MakerSpaceNewcastle/access-control-gen2/hw/RfidPillar.stl

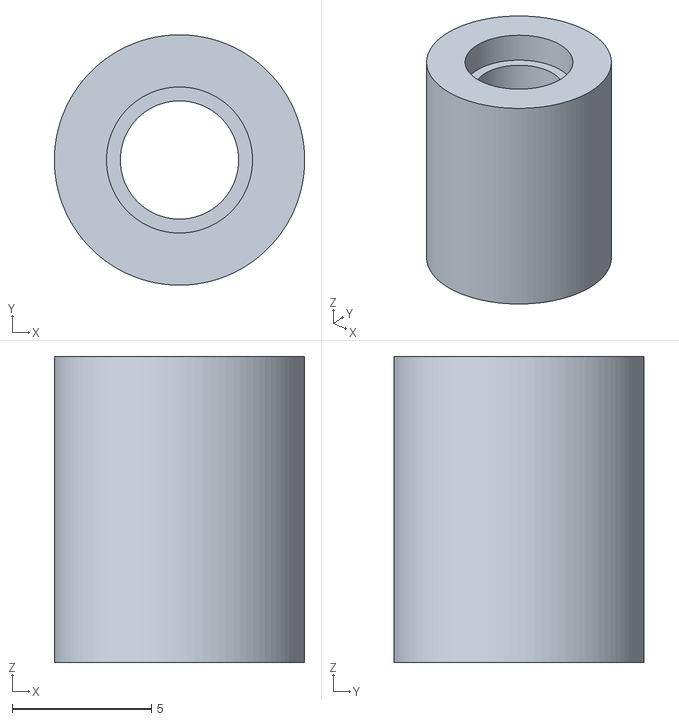
[picture p2: CAD file, 2026-01-13]
hw/RfidPillar.stl
9.00 x 9.00 x 11.0
