MakerSpaceNewcastle/access-control-gen2/hw/lv_enclosure/box.scad

use <enclosure.scad>;

Box();
