MakerSpaceNewcastle/access-control-gen2/hw/lv_enclosure/lid.scad

use <enclosure.scad>;

projection() {
  Lid();
}
