MakerSpaceNewcastle/access-control-gen2/(list of files, cad)

Other CAD files:
hw/lv_enclosure/controller_pcb.scad
