MakerSpaceNewcastle/access-control-gen2/pcb/controller/controller.kicad_pcb

## KiCad design pcb/controller/controller.kicad_pcb (2026-06-05)

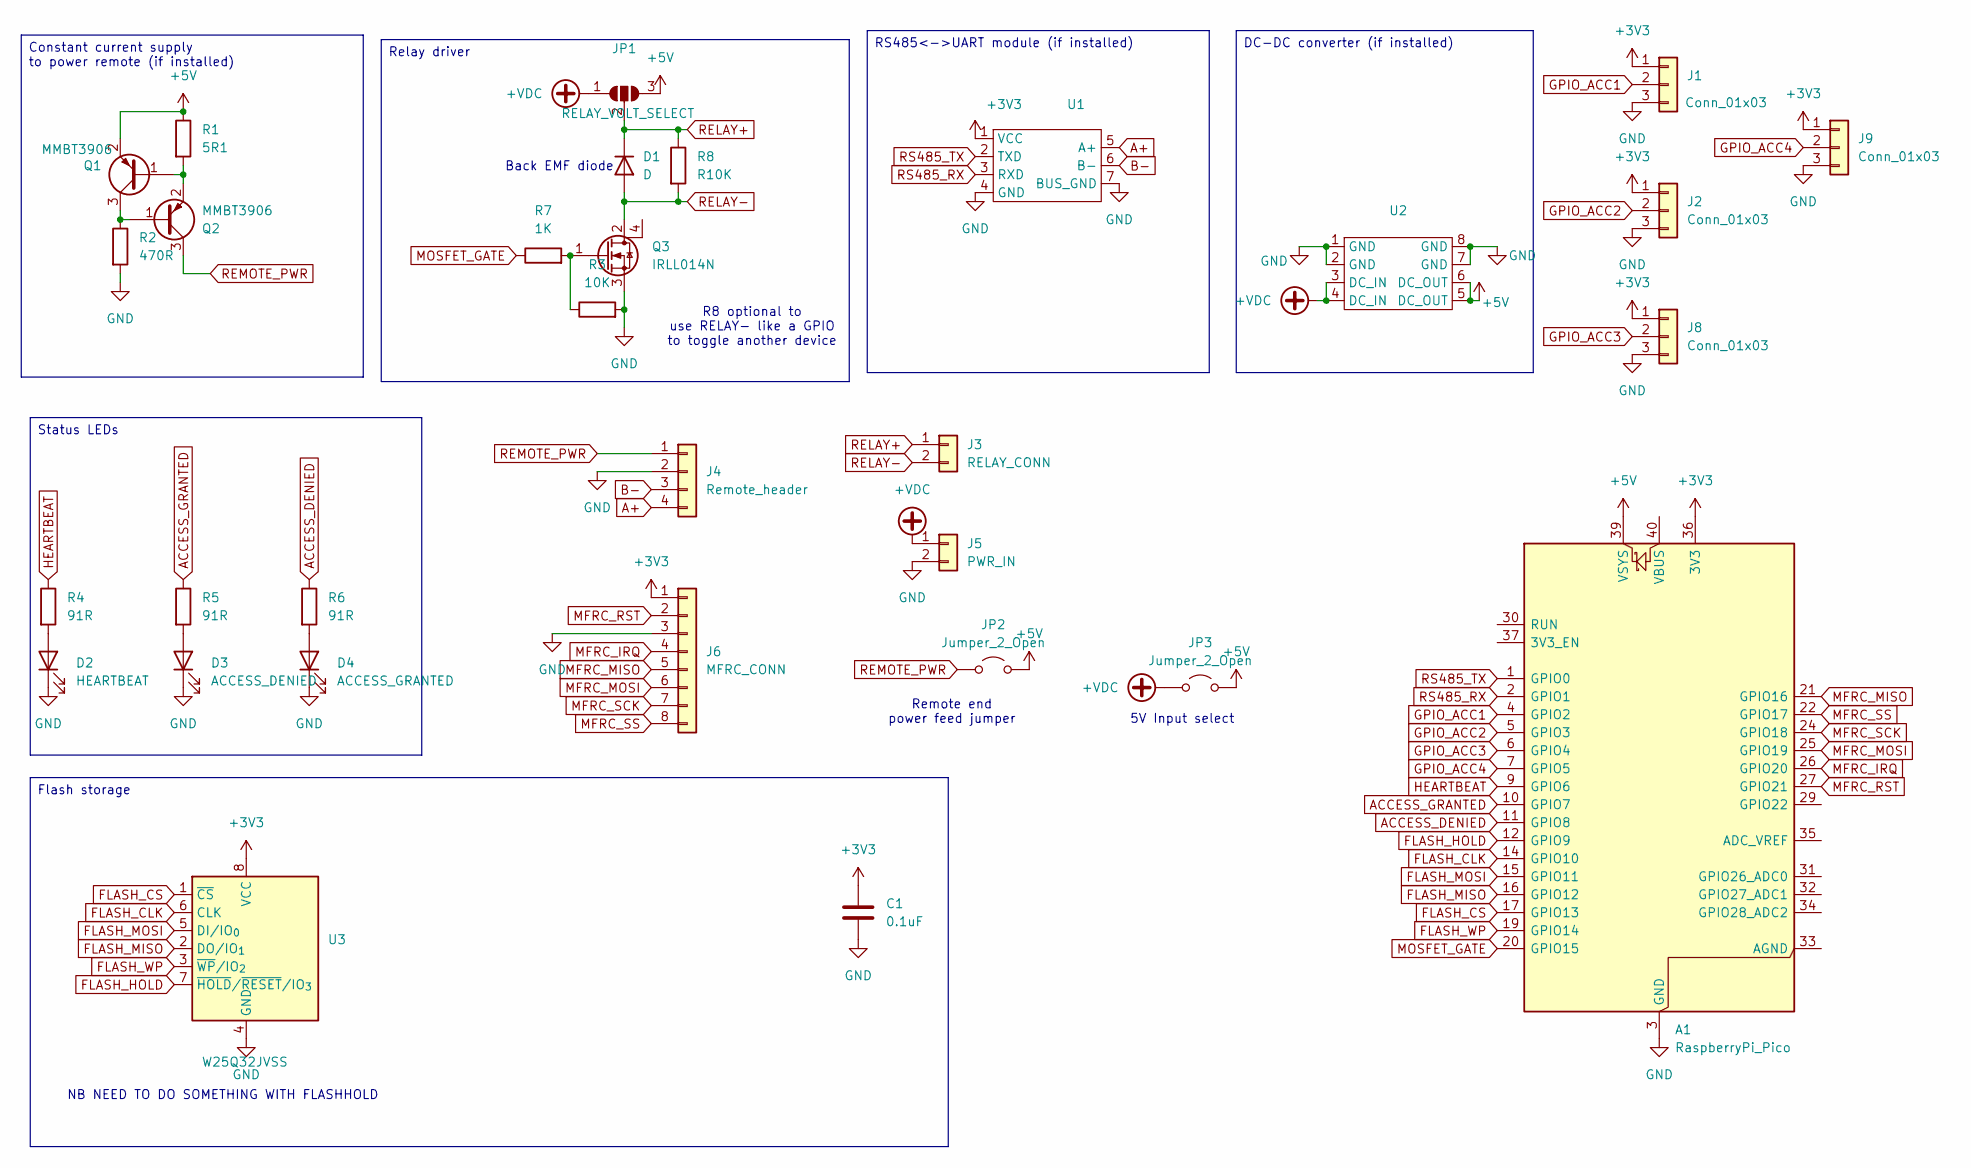
[picture p3: schematic controller.kicad_sch]

Parts:
A1: RaspberryPi_Pico; RaspberryPi_Pico_Common_Unspecified
C1: 0.1uF; C_1206_3216Metric_Pad1.33x1.80mm_HandSolder
D1: D; D_SMA-SMB_Universal_Handsoldering
D2: HEARTBEAT; LED_1206_3216Metric_Pad1.42x1.75mm_HandSolder
D3: ACCESS_DENIED; LED_1206_3216Metric_Pad1.42x1.75mm_HandSolder
D4: ACCESS_GRANTED; LED_1206_3216Metric_Pad1.42x1.75mm_HandSolder
J1, J2, J8, J9: Conn_01x03; JST_XH_B3B-XH-A_1x03_P2.50mm_Vertical
J3: RELAY_CONN; TerminalBlock_MetzConnect_Type059_RT06302HBWC_1x02_P3.50mm_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
J4: Remote_header; TerminalBlock_MetzConnect_Type059_RT06304HBWC_1x04_P3.50mm_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
J5: PWR_IN; TerminalBlock_MetzConnect_Type059_RT06302HBWC_1x02_P3.50mm_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
J6: MFRC_CONN; PinHeader_1x08_P2.54mm_Vertical
JP1: RELAY_VOLT_SELECT; SolderJumper-3_P1.3mm_Open_Pad1.0x1.5mm
JP2, JP3: Jumper_2_Open; SolderJumper-2_P1.3mm_Open_Pad1.0x1.5mm
Q1, Q2: MMBT3906; SOT-23
Q3: IRLL014N; SOT-223-3_TabPin2
R1: 5R1; R_1210_3225Metric_Pad1.30x2.65mm_HandSolder
R2: 470R; R_1210_3225Metric_Pad1.30x2.65mm_HandSolder
R3: 10K; R_1210_3225Metric_Pad1.30x2.65mm_HandSolder
R4, R5, R6: 91R; R_1210_3225Metric_Pad1.30x2.65mm_HandSolder
R7: 1K; R_1210_3225Metric_Pad1.30x2.65mm_HandSolder
R8: R10K; R_1210_3225Metric_Pad1.30x2.65mm_HandSolder
U1: RS485_to_ttl
U2: hw-1338
U3: W25Q32JVSS; SOIC-8_5.3x5.3mm_P1.27mm

Connections:
+3V3: A1.36 (3V3), C1.1, J1.1, J2.1, J6.1, J8.1, J9.1, U1.1 (VCC), U3.8 (VCC)
+5V: A1.39 (VSYS), JP1.3 (B), JP2.2 (B), JP3.2 (B), Q1.2 (E), R1.1, U2.5 (DC_OUT), U2.6 (DC_OUT)
+VDC: J5.1, JP1.1 (A), JP3.1 (A), U2.3 (DC_IN), U2.4 (DC_IN)
A+: J4.4, U1.5 (A+)
ACCESS_DENIED: A1.11 (GPIO8), R6.1
ACCESS_GRANTED: A1.10 (GPIO7), R5.1
B-: J4.3, U1.6 (B-)
FLASH_CLK: A1.14 (GPIO10), U3.6 (CLK)
FLASH_CS: A1.17 (GPIO13), U3.1 (~CS)
FLASH_HOLD: A1.12 (GPIO9), U3.7 (~HOLD/~RESET/IO_{3})
FLASH_MISO: A1.16 (GPIO12), U3.2 (DO/IO_{1})
FLASH_MOSI: A1.15 (GPIO11), U3.5 (DI/IO_{0})
FLASH_WP: A1.19 (GPIO14), U3.3 (~WP/IO_{2})
GND: A1.3 (GND), A1.8 (GND), A1.13 (GND), A1.18 (GND), A1.23 (GND), A1.28 (GND), A1.38 (GND), C1.2, D2.1 (K), D3.1 (K), D4.1 (K), J1.3, J2.3, J4.2, J5.2, J6.3, J8.3, J9.3, Q3.3 (S), R2.2, R3.2, U1.4 (GND), U1.7 (BUS_GND), U2.1 (GND), U2.2 (GND), U2.7 (GND), U2.8 (GND), U3.4 (GND)
GPIO_ACC1: A1.4 (GPIO2), J1.2
GPIO_ACC2: A1.5 (GPIO3), J2.2
GPIO_ACC3: A1.6 (GPIO4), J8.2
GPIO_ACC4: A1.7 (GPIO5), J9.2
HEARTBEAT: A1.9 (GPIO6), R4.1
MFRC_IRQ: A1.26 (GPIO20), J6.4
MFRC_MISO: A1.21 (GPIO16), J6.5
MFRC_MOSI: A1.25 (GPIO19), J6.6
MFRC_RST: A1.27 (GPIO21), J6.2
MFRC_SCK: A1.24 (GPIO18), J6.7
MFRC_SS: A1.22 (GPIO17), J6.8
MOSFET_GATE: A1.20 (GPIO15), R7.1
unnamed: D2.2 (A), R4.2
unnamed: D3.2 (A), R5.2
unnamed: D4.2 (A), R6.2
unnamed: Q1.1 (B), Q2.2 (E), R1.2
unnamed: Q1.3 (C), Q2.1 (B), R2.1
unnamed: Q3.1 (G), R3.1, R7.2
RELAY+: D1.1 (K), J3.1, JP1.2 (C), R8.1
RELAY-: D1.2 (A), J3.2, Q3.2 (D), R8.2
REMOTE_PWR: J4.1, JP2.1 (A), Q2.3 (C)
RS485_RX: A1.2 (GPIO1), U1.3 (RXD)
RS485_TX: A1.1 (GPIO0), U1.2 (TXD)

Notes on the sheet:
NB NEED TO DO SOMETHING WITH FLASHHOLD
Back EMF diode
R8 optional to use RELAY- like a GPIO to toggle another device
Remote end power feed jumper
5V Input select
Status LEDs
DC-DC converter (if installed)
Relay driver
RS485<->UART module (if installed)
Flash storage
Constant current supply to power remote (if installed)

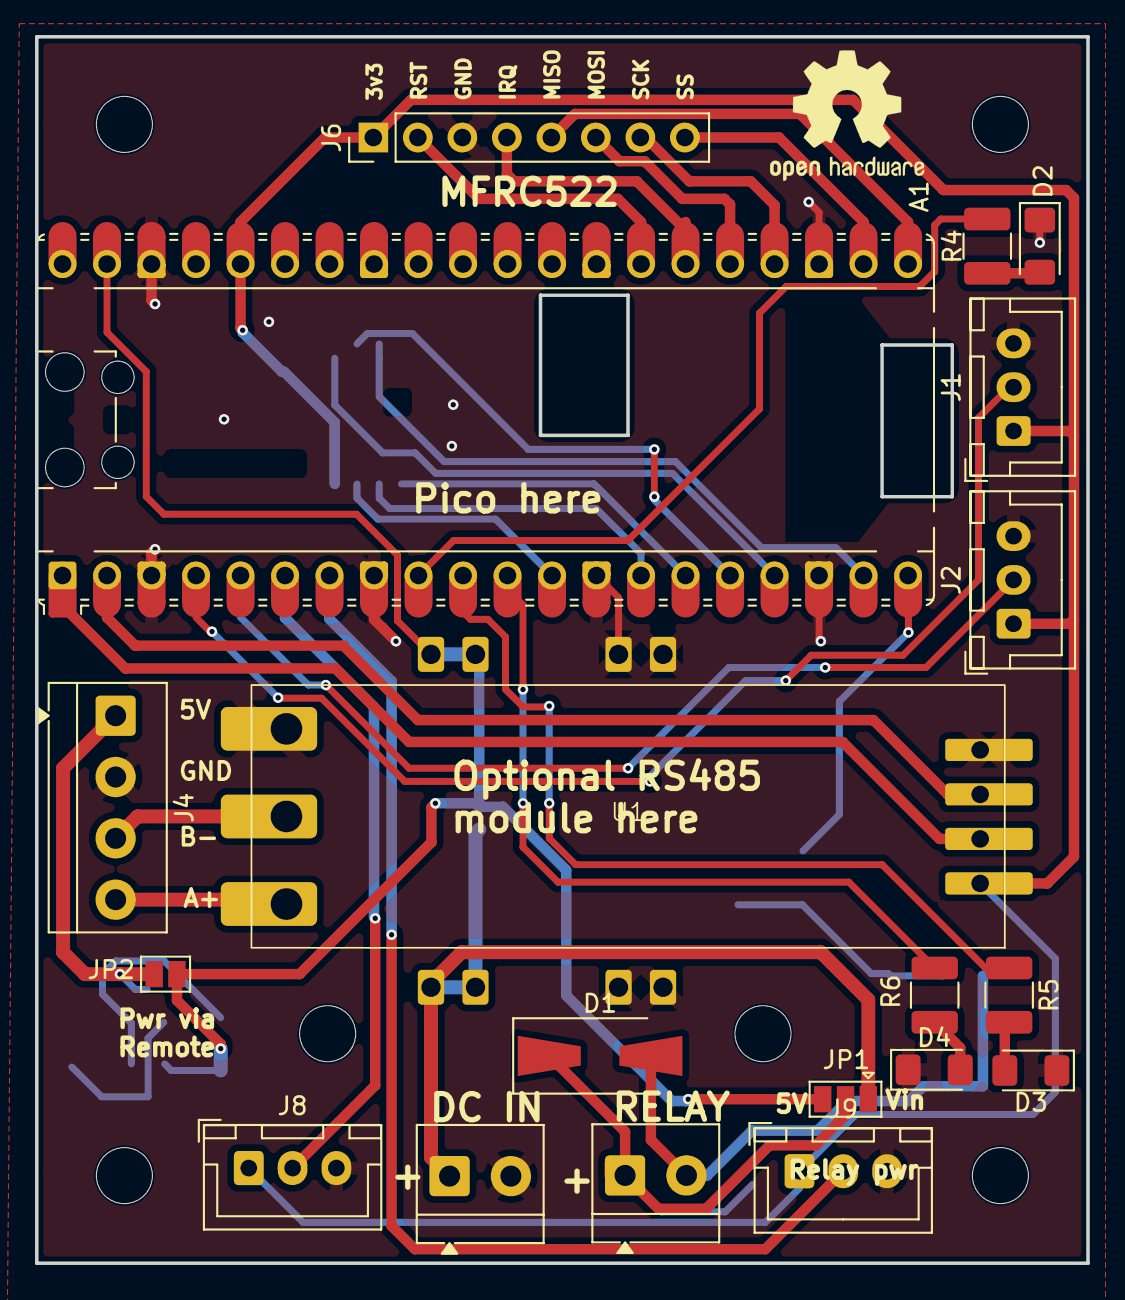
[picture p4: board controller.kicad_pcb from above]

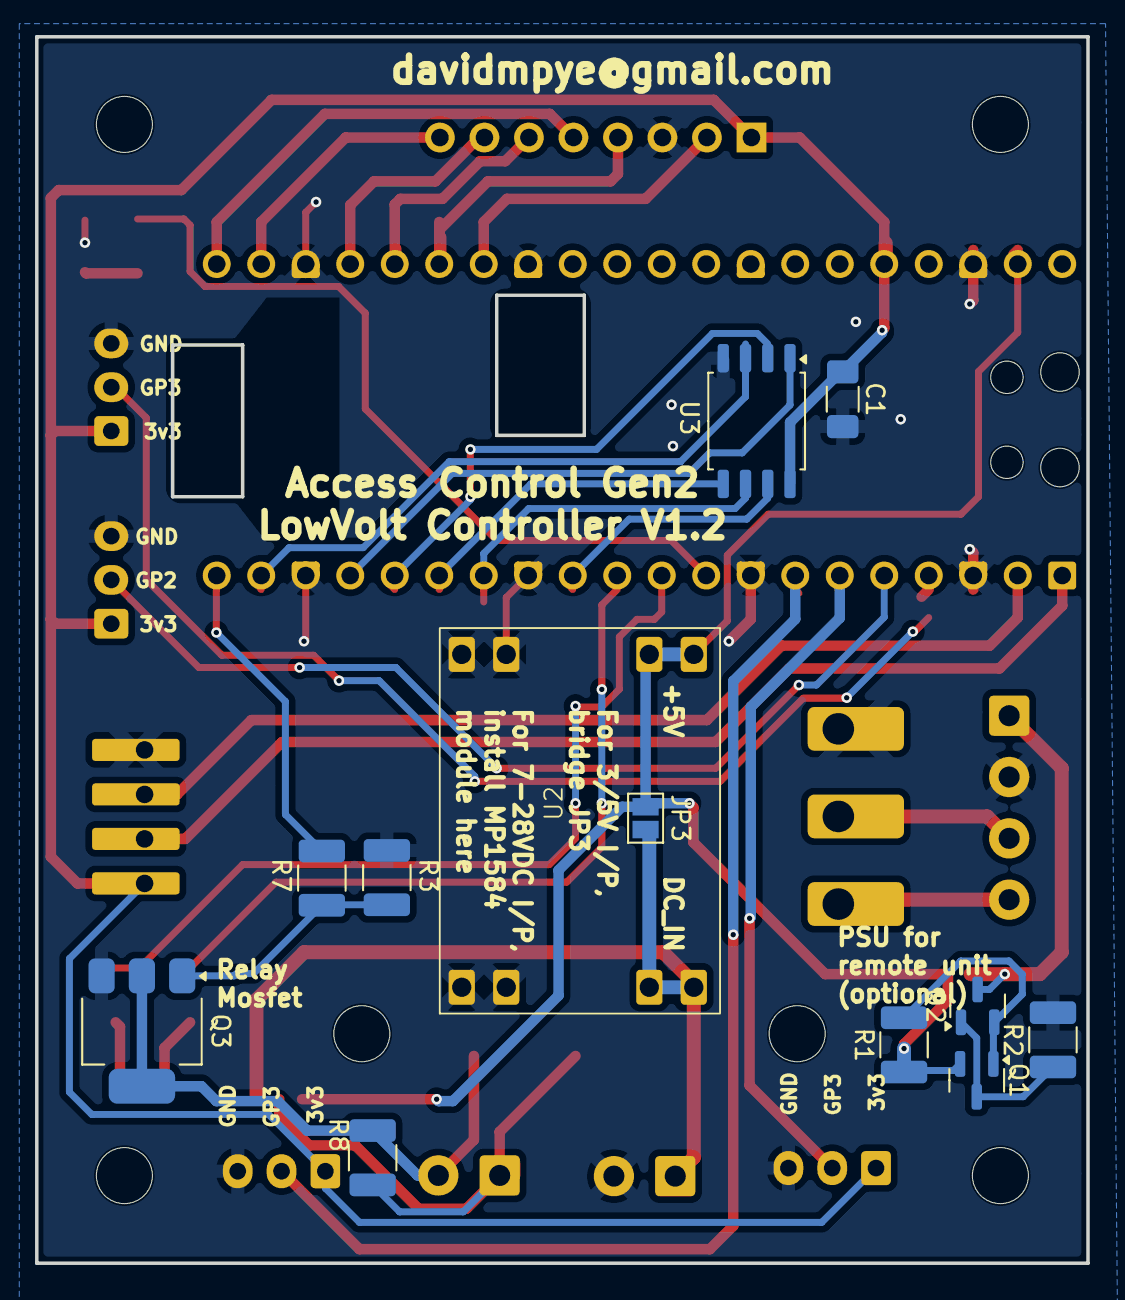
[picture p5: board controller.kicad_pcb from below]

Board: 2 copper layers, 60.0 x 70.0 mm, 31 parts (12 on the bottom side), 37 nets.
