MakerSpaceNewcastle/access-control-gen2/(commit log)

2026-01-07 Make watchdog led less irritating (take 1)
2026-01-13 Updated pillarx
    [RfidPillar.scad, RfidPillar.stl]
2026-05-28 Add missing gitignore for KiCad projects
2026-05-30 Add enclosure for LV controller
    [box.scad, controller_pcb.scad, enclosure.scad, lid.scad, thatbox.scad]
2026-06-02 Update to kicad10 format
    [controller.kicad_pcb, controller.kicad_sch]
2026-06-03 Change footprint to use through-hole, add Edge.cuts cutout for debug pins.
    [controller.kicad_pcb, controller.kicad_sch]
2026-06-03 PCB tweaks
    [controller.kicad_pcb]
2026-06-03 Update pcby
    [controller.kicad_pcb]
2026-06-04 Track rerouting
    [controller.kicad_pcb]
2026-06-05 More minor PCB tweaks
    [controller.kicad_pcb]
2026-06-09 Correct LV enclosure back spacing
    [enclosure.scad]
